nonik0/IN13-Nixie-Device/images/prototype_no_case_2.jpg

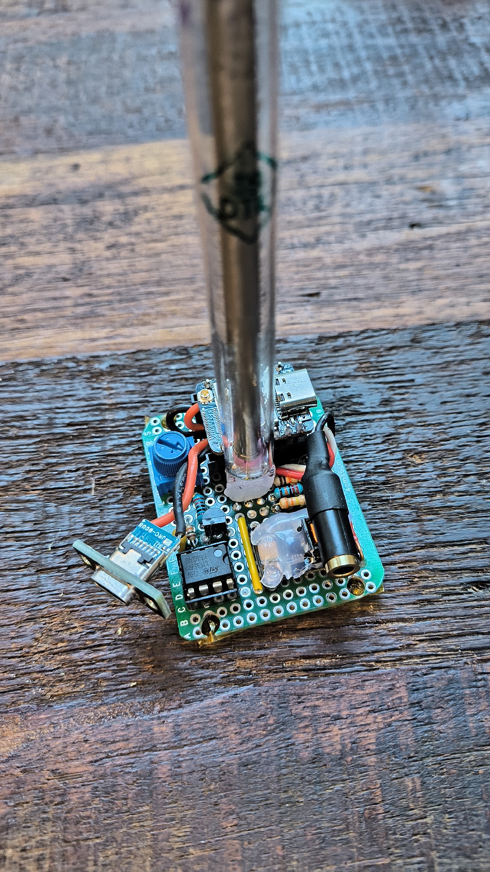
images/prototype_no_case_2.jpg
