nonik0/IN13-Nixie-Device/images/kapton_bottom.jpg

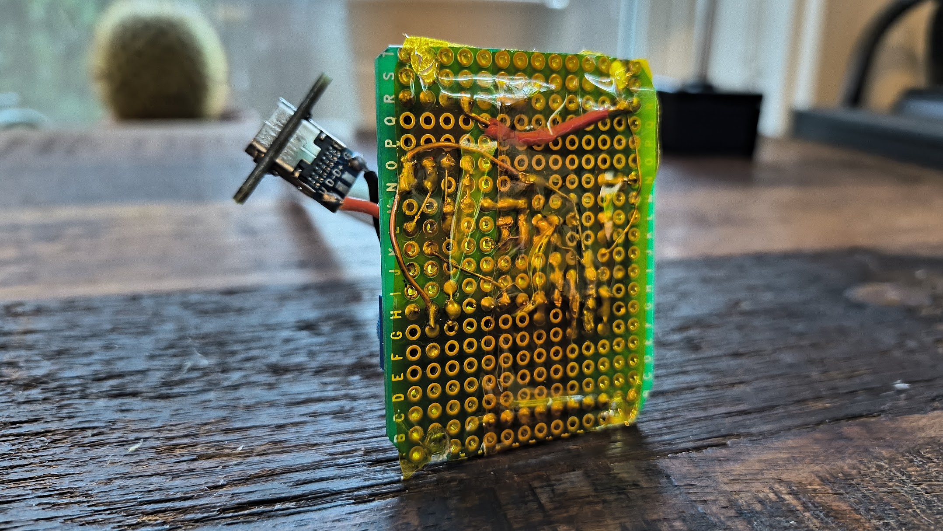
images/kapton_bottom.jpg
