nonik0/IN13-Nixie-Device/images/prototype_at_home.jpg

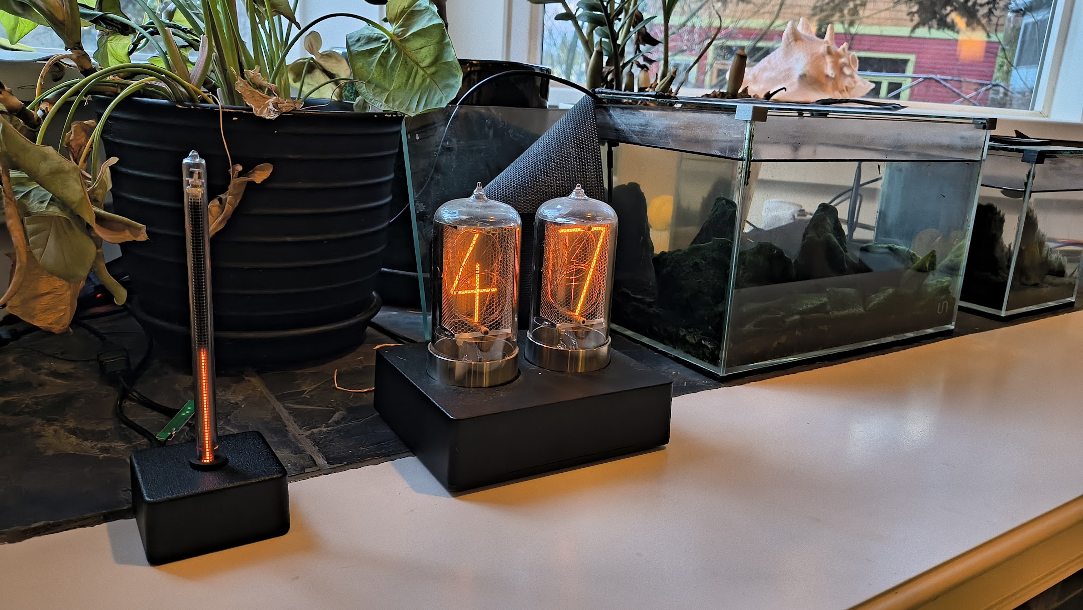
images/prototype_at_home.jpg
