nonik0/IN13-Nixie-Device/images/prototype_fitting.jpg

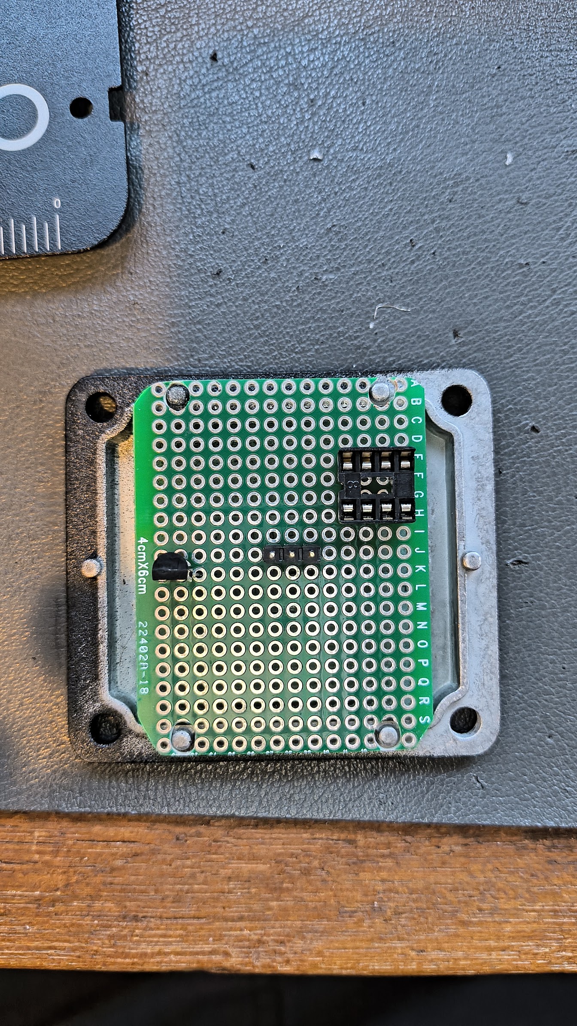
images/prototype_fitting.jpg
