nonik0/IN13-Nixie-Device/images/prototype_no_case.jpg

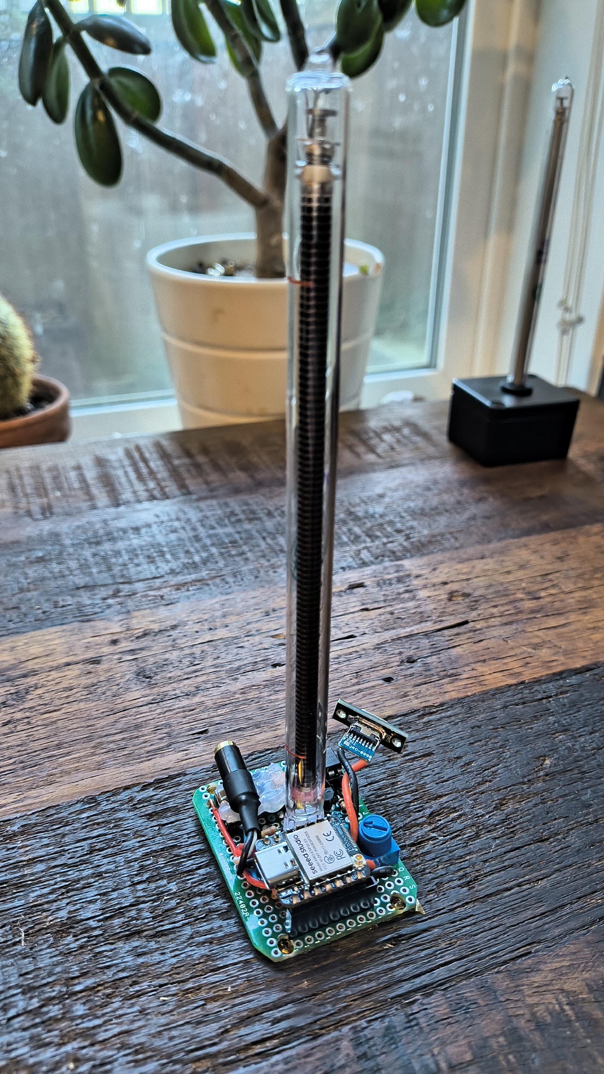
images/prototype_no_case.jpg
