nonik0/IN13-Nixie-Device/hardware/kicad10.0/IN13-Nixie-Device.kicad_pcb

## KiCad design hardware/kicad10.0/IN13-Nixie-Device.kicad_pcb (2026-04-14)

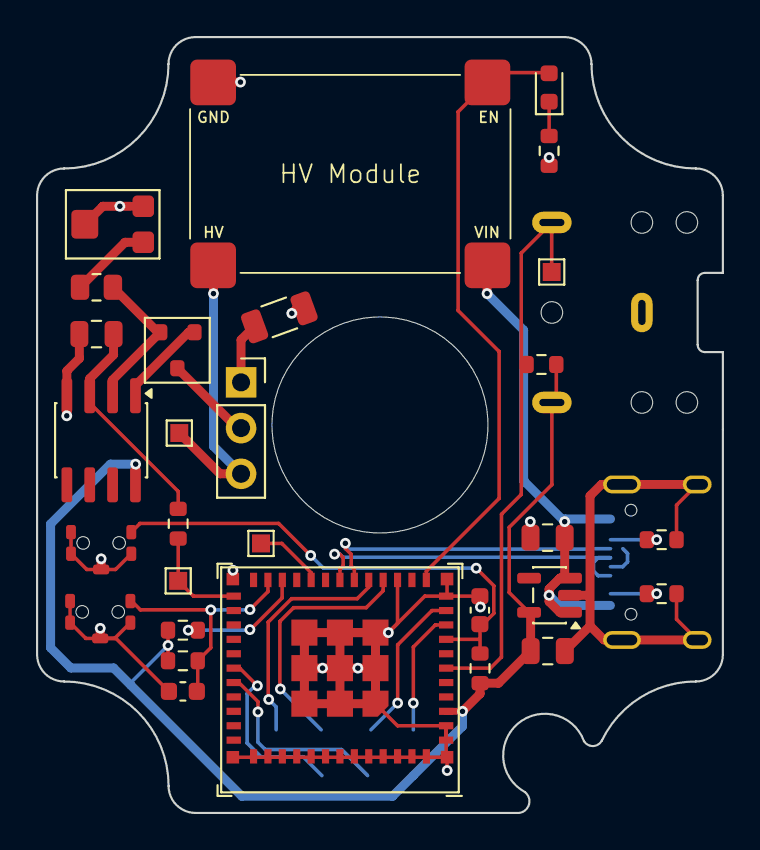
[picture p6: board IN13-Nixie-Device.kicad_pcb from above]

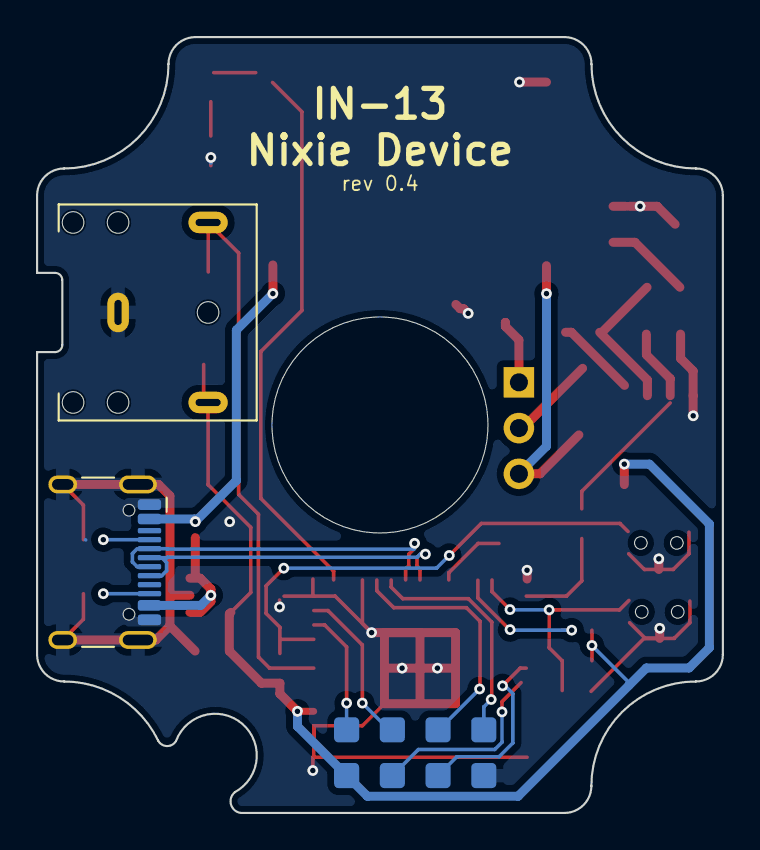
[picture p7: board IN13-Nixie-Device.kicad_pcb from below]

Board: 2 copper layers, 38.1 x 43.1 mm, 33 parts (4 on the bottom side), 28 nets.

Parts:
C2: 100nF; C_0805_2012Metric
C3, C4: 1u; C_0603_1608Metric
C9, C12: 22u; C_0805_2012Metric
D3: LED; LED_0603_1608Metric
J1: PINHD_1x3_Female; PinSocket_1x03_P2.54mm_Vertical
J2: AudioJack3; Jack_3.5mm_CUI_SJ1-3523N_Horizontal_NoEdgeSilkscreen
J3: USB_C_Receptacle_USB2.0_16P; USB_C_Receptacle_HCTL_HC-TYPE-C-16P-01A
J4, J5: PINHD_1x4_Male; Pads_1x4_2.54mm
Q1: MMBTA42; SOT-23
R1: 220k; R_1206_3216Metric
R2, R3, R5, R6, R11: 10k; R_0603_1608Metric
R4: 330; R_0805_2012Metric
R12, R13: 5.1K; R_0603_1608Metric
R14: 220; R_0603_1608Metric
RV1: 2k; Potentiometer_Bourns_TC33X_Vertical
SW1, SW2: SW_Push; Mitsumi_SOFSeries_SMD_Button
TP1, TP2, TP4, TP5: TestPoint; TestPoint_Pad_1.0x1.0mm
U1: LM358; SOIC-8_3.9x4.9mm_P1.27mm
U2: ESP32-C6-MINI-1/U; ESP32-C6-MINI-1U
U4: AP2112K-3.3; SOT-23-5
U11: HV Module; AliExpress_HV_Module

Connections:
+3.3V: C12.1, J2.T, J4.1, R2.1, R5.2, R6.2, R11.1, U1.8 (V+), U2.3 (3V3), U4.5 (VOUT)
BOOT: C4.1, R6.1, SW2.1 (A), U2.23 (GPIO9)
D+: J3.A6 (D+), J3.B6 (D+), U2.18 (GPIO13/USB_D+)
D-: J3.A7 (D-), J3.B7 (D-), U2.17 (GPIO12/USB_D-)
EN: C3.1, R2.2, SW1.1 (A), U2.8 (EN/CHIP_PU)
GND: C2.2, C3.2, C4.2, C9.2, C12.2, J2.S, J3.A1 (GND), J3.A12 (GND), J3.B1 (GND), J3.B12 (GND), J3.SH (SHIELD), J4.4, R1.1, R12.2, R13.2, R14.1, RV1.2, RV1.3, SW1.2 (B), SW1.3 (GND), SW2.2 (B), SW2.3 (GND), U1.4 (V-), U2.1 (GND), U2.2 (GND), U2.11 (GND), U2.14 (GND), U2.36 (GND), U2.37 (GND), U2.38 (GND), U2.39 (GND), U2.40 (GND), U2.41 (GND), U2.42 (GND), U2.43 (GND), U2.44 (GND), U2.45 (GND), U2.46 (GND), U2.47 (GND), U2.48 (GND), U2.49 (GND), U2.50 (GND), U2.51 (GND), U2.52 (GND), U2.53 (GND), U4.2 (GND), U11.3 (Gnd)
HV: J1.3, TP2.1, U11.4 (Vout)
HVEN: D3.2 (A), U2.12 (GPIO0/ADC1_CH0/XTAL_32K_P), U11.2 (EN)
unnamed: D3.1 (K), R14.2
unnamed: J1.1, R1.2
unnamed: J3.A5 (CC1), R12.1
unnamed: J3.B5 (CC2), R13.1
unnamed: Q1.1 (B), U1.1
unnamed: J1.2, Q1.3 (C)
unnamed: Q1.2 (E), R4.1, U1.2 (-)
unnamed: R4.2, RV1.1
unnamed: C2.1, R3.1, U1.3 (+)
unnamed: R5.1, U2.22 (GPIO8)
unnamed: TP5.1 (1_1), U2.20 (GPIO15)
PWM: R3.2, TP1.1 (1_1), U2.25 (GPIO19)
RX: J4.3, U2.30 (U0RXD/GPIO17)
SIGNAL: J2.R, R11.2, TP4.1 (1_1), U2.6 (GPIO3/ADC1_CH3)
TCK: J5.3, U2.15 (MTCK/GPIO6/ADC1_CH6)
TDI: J5.2, U2.10 (MTDI/GPIO5/ADC1_CH5)
TDO: J5.4, U2.16 (MTDO/GPIO7)
TMS: J5.1, U2.9 (MTMS/GPIO4/ADC1_CH4)
TX: J4.2, U2.31 (U0TXD/GPIO16)
VBUS: C9.1, J3.A4 (VBUS), J3.A9 (VBUS), J3.B4 (VBUS), J3.B9 (VBUS), U4.1 (VIN), U4.3 (EN), U11.1 (Vin)
