nonik0/IN13-Nixie-Device/hardware/kicad8.0/IN13-Device.kicad_pcb

## KiCad design hardware/kicad8.0/IN13-Device.kicad_pcb (2025-03-23)

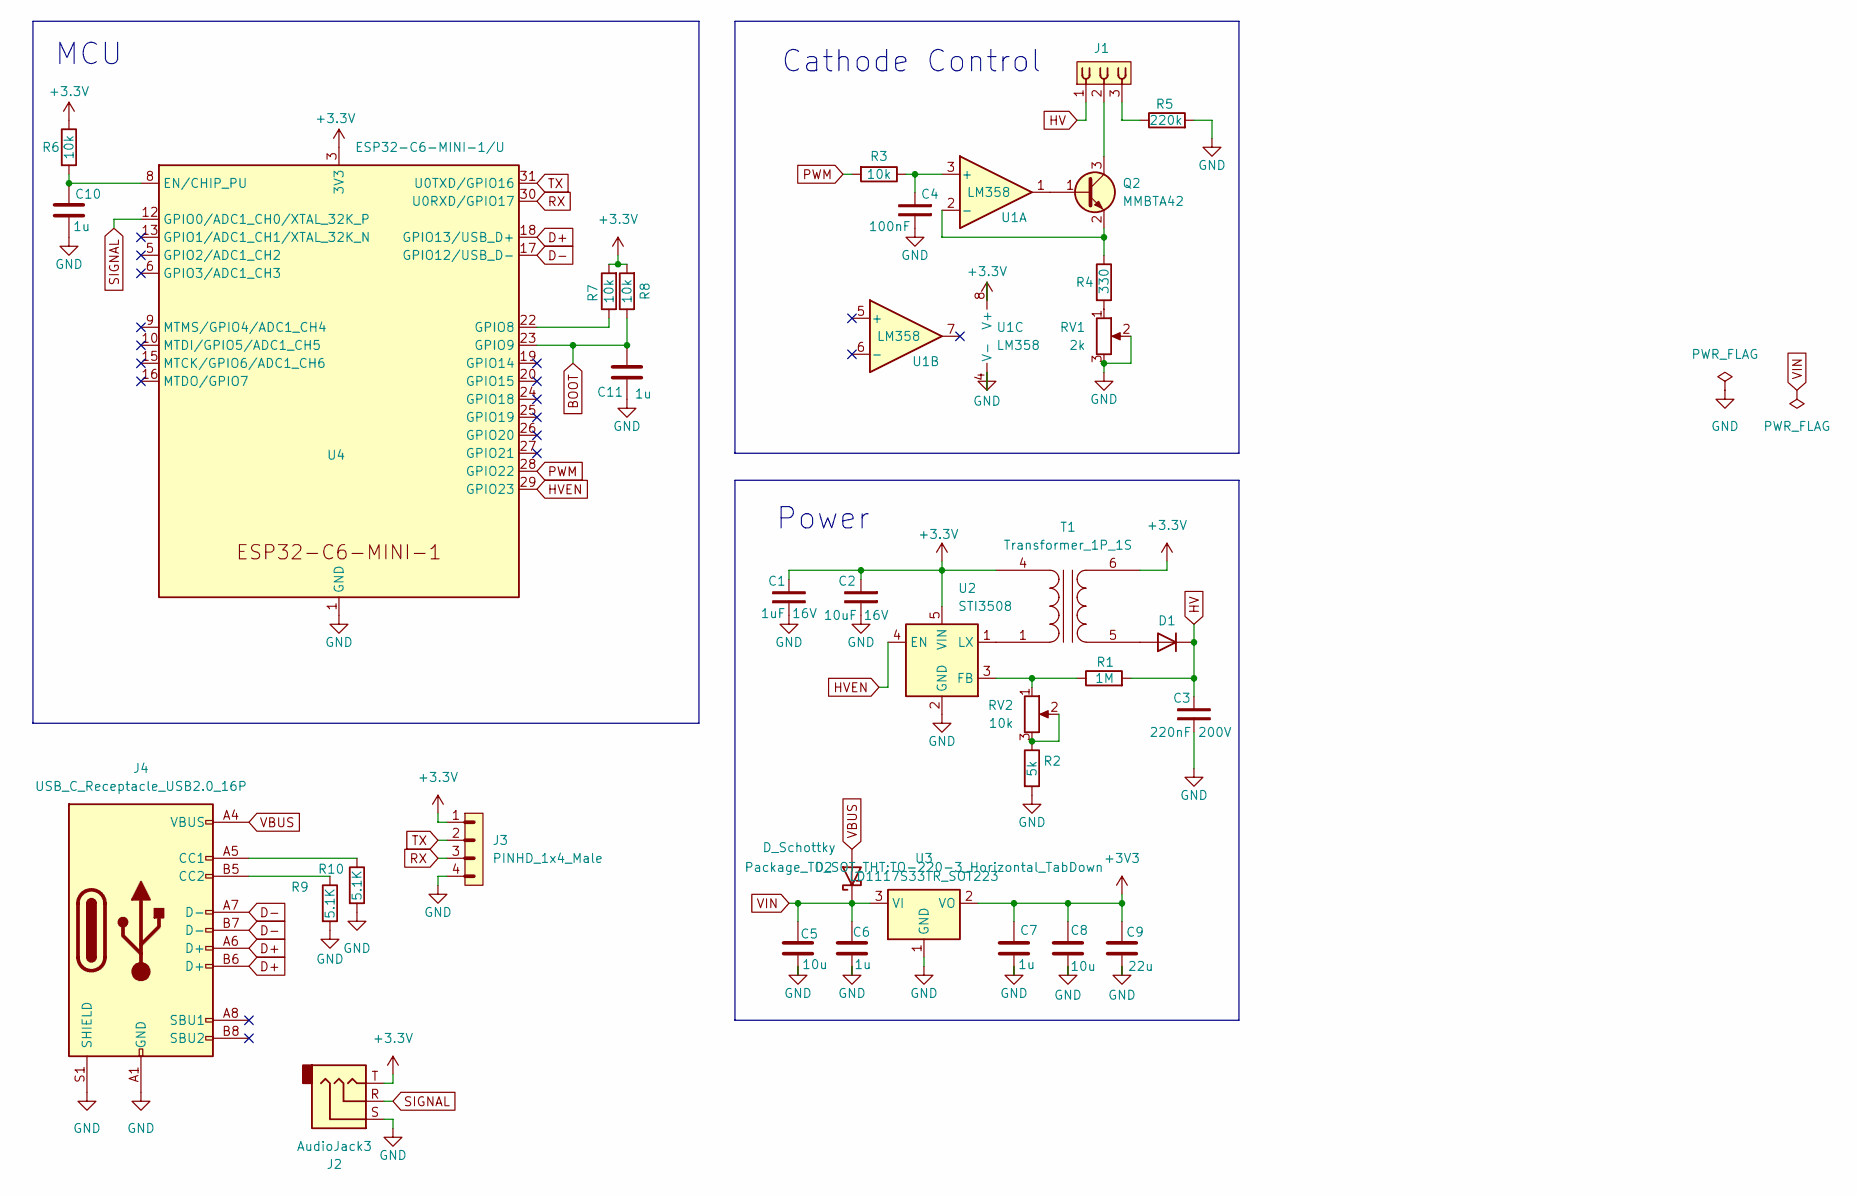
[picture p8: schematic IN13-Device.kicad_sch, IN-13 Device]

Parts:
C1: 1uF 16V; C_0805_2012Metric
C2: 10uF 16V; C_0805_2012Metric
C3: 220nF 200V; C_1210_3225Metric
C4: 100nF; C_0805_2012Metric
C5, C8: 10u; C_0805_2012Metric
C6, C7, C10, C11: 1u; C_0805_2012Metric
C9: 22u; C_0805_2012Metric
D1: US1G; D_SMA
D2: D_Schottky; D_0805_2012Metric
J1: PINHD_1x3_Female; PinSocket_1x03_P2.54mm_Vertical
J2: AudioJack3; Jack_3.5mm_CUI_SJ1-3523N_Horizontal
J3: PINHD_1x4_Male; PinHeader_1x04_P2.54mm_Vertical
J4: USB_C_Receptacle_USB2.0_16P; USB_C_Receptacle_HCTL_HC-TYPE-C-16P-01A
Q2: MMBTA42; SOT-23
R1: 1M; R_0805_2012Metric
R2: 5k; R_0805_2012Metric
R3, R6, R7, R8: 10k; R_0805_2012Metric
R4: 330; R_0805_2012Metric
R5: 220k; R_1206_3216Metric
R9, R10: 5.1K; R_0603_1608Metric
RV1: 2k; Potentiometer_Bourns_TC33X_Vertical
RV2: 10k; Potentiometer_Bourns_TC33X_Vertical
T1: Transformer_1P_1S; EE0504S
U1: LM358; SOIC-8-1EP_3.9x4.9mm_P1.27mm_EP2.41x3.81mm
U2: STI3508; SOT-23-6
U3: LD1117S33TR_SOT223; TO-220-3_Horizontal_TabDown
U4: ESP32-C6-MINI-1/U; ESP32-C6-MINI-1U

Connections:
+3.3V: C1.2, C2.1, J2.T, J3.1, R6.1, R7.2, R8.2, T1.4 (AA), T1.6 (SB), U1.8 (V+), U2.5 (VIN), U4.3 (3V3)
+3V3: C7.1, C8.1, C9.1, U3.2 (VO)
BOOT: C11.1, R8.1, U4.23 (GPIO9)
D+: J4.A6 (D+), J4.B6 (D+), U4.18 (GPIO13/USB_D+)
D-: J4.A7 (D-), J4.B7 (D-), U4.17 (GPIO12/USB_D-)
GND: C1.1, C2.2, C3.1, C4.2, C5.2, C6.2, C7.2, C8.2, C9.2, C10.2, C11.2, J2.S, J3.4, J4.A1 (GND), J4.A12 (GND), J4.B1 (GND), J4.B12 (GND), J4.S1 (SHIELD), R2.2, R5.2, R9.2, R10.2, RV1.2, RV1.3, U1.4 (V-), U2.2 (GND), U3.1 (GND), U4.1 (GND), U4.2 (GND), U4.11 (GND), U4.14 (GND), U4.36 (GND), U4.37 (GND), U4.38 (GND), U4.39 (GND), U4.40 (GND), U4.41 (GND), U4.42 (GND), U4.43 (GND), U4.44 (GND), U4.45 (GND), U4.46 (GND), U4.47 (GND), U4.48 (GND), U4.49 (GND), U4.50 (GND), U4.51 (GND), U4.52 (GND), U4.53 (GND)
HV: C3.2, D1.1 (K), J1.1, R1.2
HVEN: U2.4 (EN), U4.29 (GPIO23)
unnamed: D1.2 (A), T1.5 (SA)
unnamed: J1.3, R5.1
unnamed: J4.A5 (CC1), R10.1
unnamed: J4.B5 (CC2), R9.1
unnamed: Q2.1 (B), U1.1
unnamed: J1.2, Q2.3 (C)
unnamed: Q2.2 (E), R4.1, U1.2 (-)
unnamed: R2.1, RV2.2, RV2.3
unnamed: R4.2, RV1.1
unnamed: T1.1 (AB), U2.1 (LX)
unnamed: C4.1, R3.1, U1.3 (+)
unnamed: R1.1, RV2.1, U2.3 (FB)
unnamed: C10.1, R6.2, U4.8 (EN/CHIP_PU)
unnamed: R7.1, U4.22 (GPIO8)
PWM: R3.2, U4.28 (GPIO22)
RX: J3.3, U4.30 (U0RXD/GPIO17)
SIGNAL: J2.R, U4.12 (GPIO0/ADC1_CH0/XTAL_32K_P)
TX: J3.2, U4.31 (U0TXD/GPIO16)
VBUS: D2.2 (A), J4.A4 (VBUS), J4.A9 (VBUS), J4.B4 (VBUS), J4.B9 (VBUS)
VIN: C5.1, C6.1, D2.1 (K), U3.3 (VI)

Notes on the sheet:
Cathode Control
MCU
Power

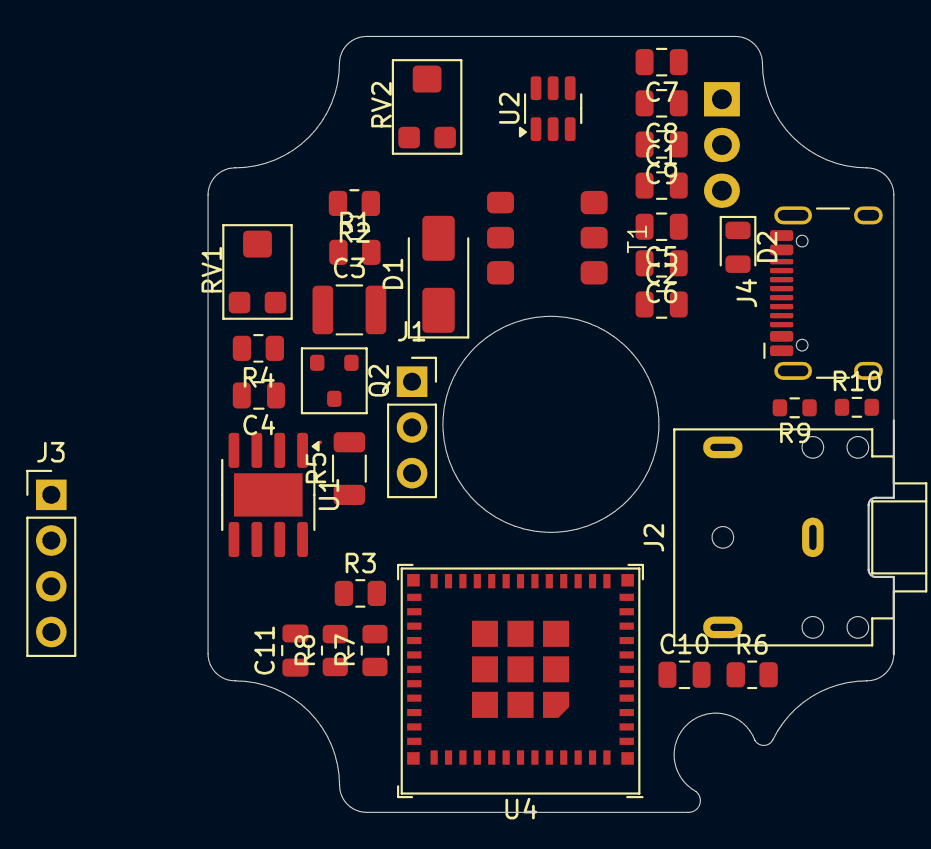
[picture p9: board IN13-Device.kicad_pcb from above]

Board: 2 copper layers, 38.1 x 43.1 mm, 35 parts (1 on the bottom side), 28 nets.
