nonik0/IN13-Nixie-Device/firmware/cpp/display_task_handler.h

#pragma once
#include <Arduino.h>

class DisplayTaskHandler
{
protected:
    static const int MaxMessageSize = 100;

    volatile bool _display = true;
    char _message[MaxMessageSize];
    TaskHandle_t _taskHandle = NULL;

public:
    virtual bool createTask() = 0;

    char *getMessage() { return _message; }

    virtual void setDisplay(bool displayState) { _display = displayState; }

    virtual void setMessage(const char *message) { strncpy(_message, message, MaxMessageSize); }

    template <typename... Args>
    void setMessage(const char *format, Args... args)
    {
        snprintf(_message, MaxMessageSize, format, args...);
    }

    bool suspendTask()
    {
        if (_taskHandle != NULL)
        {
            vTaskSuspend(_taskHandle);
            return true;
        }
        return false;
    }

protected:
    virtual void task(void *parameters) = 0;

    static void taskWrapper(void *parameters)
    {
        DisplayTaskHandler *handler = static_cast<DisplayTaskHandler *>(parameters);
        handler->task(parameters);
    }
};
