nonik0/IN13-Nixie-Device/(commit log)

2025-02-07 initial commit, schematic in progress
    [IN13-Device.kicad_pcb, IN13-Device.kicad_sch]
2025-03-01 finished basic schematic
    [IN13-Device.kicad_sch]
2025-03-03 starting pwm
2025-03-03 cathode control and temperature tasks
2025-03-05 pin updates
2025-03-07 pcb edge cut
    [IN13-Device.kicad_pcb]
2025-03-09 esp32c6 module
    [IN13-Device.kicad_pcb, IN13-Device.kicad_sch]
2025-03-24 layout progress, kicad proj rename
    [IN13-Nixie-Device.kicad_pcb, IN13-Nixie-Device.kicad_sch]
2025-03-26 starting traces
    [IN13-Nixie-Device.kicad_pcb, IN13-Nixie-Device.kicad_sch]
2025-04-07 layout passing DRC (except USB conn)
    [IN13-Nixie-Device.kicad_pcb, IN13-Nixie-Device.kicad_sch]
2025-04-07 usb line adjust
    [IN13-Nixie-Device.kicad_pcb, IN13-Nixie-Device.kicad_sch]
2025-04-15 final board revisions and images
    [IN13-Nixie-Device.kicad_pcb, IN13-Nixie-Device.kicad_sch]
2025-07-08 pcb revision
    [IN13-Nixie-Device.kicad_pcb, IN13-Nixie-Device.kicad_sch]
2025-09-19 pcb revision, improve boost circuit
    [IN13-Nixie-Device.kicad_pcb, IN13-Nixie-Device.kicad_sch]
2026-04-11 pivot to hv module, kicad 10.0
    [IN13-Nixie-Device.kicad_pcb, IN13-Nixie-Device.kicad_sch]
2026-04-11 schematic fixes
    [IN13-Nixie-Device.kicad_sch]
2026-04-11 schematic and layour rework start
    [IN13-Nixie-Device.kicad_pcb, IN13-Nixie-Device.kicad_sch]
2026-04-13 revision passing DRC
    [IN13-Nixie-Device.kicad_pcb, IN13-Nixie-Device.kicad_sch]
2026-04-14 final rev 0.4
    [IN13-Nixie-Device.kicad_pcb, IN13-Nixie-Device.kicad_sch]
